NicholasJohnAlvarez/LED-Cube-Hub/Hardware/PCB/BOM_CubeHUB_2026-01-13.csv

Quantity | Manufacturer Part | Supplier
1 | PH2.0mm-2AWB | LCSC
6 | CAPCER0.1UF16VX5R0603,CAPCER0.1UF25VX5R0603,CAPCER0.1UF16VX7R0603 | LCSC
1 | CGA3E1X7T0J106M080AC | LCSC
3 | C2012X7S0J226M125AC | LCSC
1 | 0805B106K250NT | LCSC
1 | XFL4020-152MEC | LCSC
1 | WS2812D-F5 | LCSC
1 | AO3401A | LCSC
3 | RT0805FRE072KL | LCSC
2 | AF0805FR-07200KL | LCSC
5 | RT0603BRC0710KL | LCSC
7 | ERJS030R00V | LCSC
3 | ERJ-3RED33R0V | LCSC
1 | ERJ3EKF6812V | LCSC
1 | ERJ3EKF3653V | LCSC
1 | DS2431+ | LCSC
3
1 | LIS3DHTR | LCSC
1 | XIAO ESP32C3
1 | TPS630701RNMT | LCSC
