NicholasJohnAlvarez/LED-Cube-Hub/Hardware/3D_Models/Seeed Studio XIAO-ESP32-C3 v15.obj

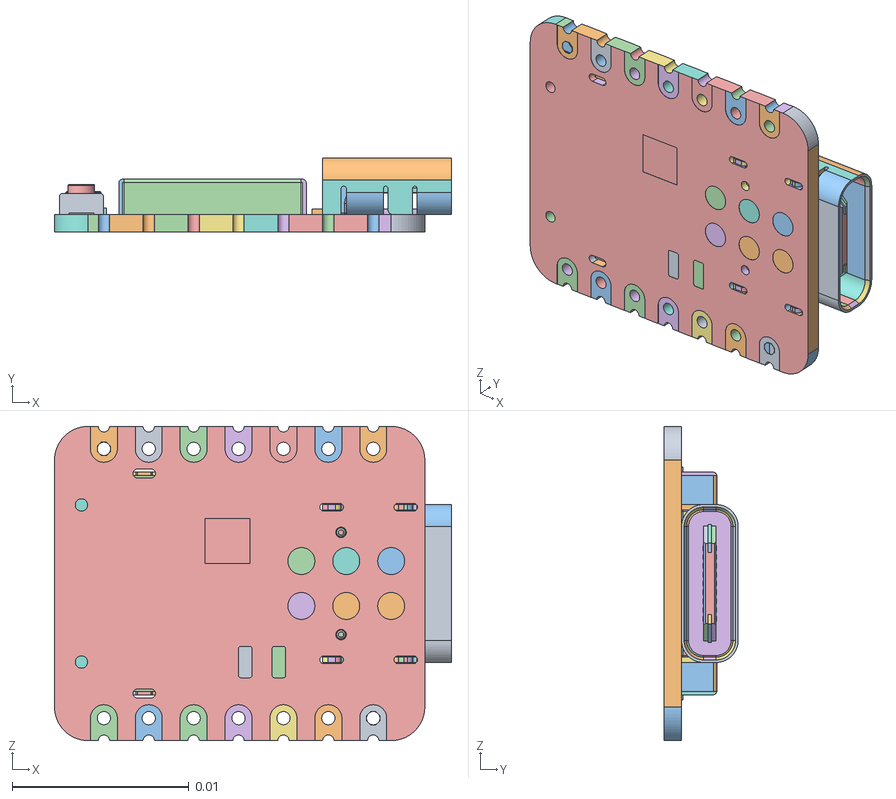
[picture p2: CAD file, 2026-01-15]
Hardware/3D_Models/Seeed Studio XIAO-ESP32-C3 v15.obj
0.0225 x 0.00421 x 0.0178
