NicholasJohnAlvarez/LED-Cube-Hub/(commit log)

2026-01-15 Initial commit: LED Cube Hub v2.1 - Refactored 3-file structure
2026-01-15 Add PCB designs and hardware documentation
    [BOM_CubeHUB_2026-01-13.csv, Seeed Studio XIAO-ESP32-C3 v15.obj, Seeed Studio XIAO-ESP32-C3.step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]
2026-02-08 v2.3: Modular cube programming, battery fixes, v3 hardware support
    - Simplified cube programming (branch/index addressing)
    - Factory-calibrated battery measurement (analogReadMilliVolts)
    - Deep sleep wake fixes (timing and Serial.flush removal)
    - v3 hardware: GPIO9/10 swap to avoid strapping pin issues
    - Triple-flip sleep gesture (3 flips in 1.5s)
    - Increased flip threshold (-13000) to prevent false triggers
    - Cleaned up documentation (single README instead of 5 files)
    [hardware.cpp, hardware.h, main.cpp]
